den47k/incident-recorder/docs/screenshots/wokwi-uart.png

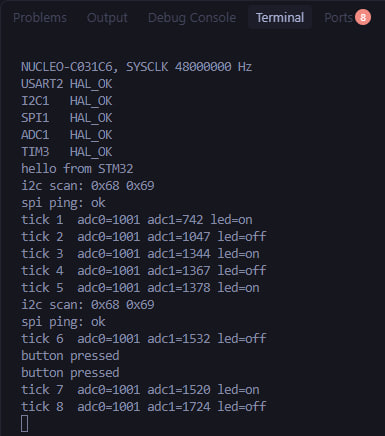
docs/screenshots/wokwi-uart.png
