den47k/incident-recorder/docs/hardware-components.md

# Апаратні компоненти Incident Recorder

## 1. Плата NUCLEO-C031C6
* **Мікроконтролер:** STM32C031C6 у корпусі LQFP48. Ядро Cortex-M0+ на 48 МГц, 32 КБ Flash, 12 КБ RAM.
* **Живлення:** плата живиться від USB через вбудований ST-LINK. Сам мікроконтролер працює від 2.0 до 3.6 В.
* **Тактування:** внутрішній генератор HSI на 48 МГц без дільника. На такій частоті Flash потребує 1 такт очікування, CubeMX виставляє його сам.
* **Піни інтерфейсів:**
  * USART2: PA2 - TX, PA3 - RX (AF1).
  * I2C1: PA9 - SCL, PA10 - SDA (AF6). На кристалі цей самий I2C1 виведений ще на PB6/PB7, але модель Wokwi працює тільки з PA9/PA10.
  * SPI1: PB3 - SCK, PB4 - MISO, PB5 - MOSI (AF0). CS - звичайний вихід PB0.
  * ADC1: PA0 - канал IN0, PA1 - канал IN1.
  * TIM3_CH1 (ШІМ): PA6 (AF1).
  * Кнопка: PA12 (лінія EXTI12). Вбудований світлодіод LD4: PA5.
* **Datasheet (DS13867 Rev 3, STM32C031x4/x6):** <https://www.farnell.com/datasheets/3916623.pdf>
  * с. 1 - параметри мікроконтролера і живлення
  * с. 31 - піни АЦП
  * с. 36–37 - альтернативні функції портів A і B
* **Reference manual (RM0490):** <https://www.st.com/resource/en/reference_manual/rm0490-stm32c0-series-advanced-armbased-32bit-mcus-stmicroelectronics.pdf>
  * с. 59 - такти очікування Flash
  * с. 125 - генератор HSI48

P.S. Було обрано NUCLEO-C031C6, а не F411/F446, тому що Wokwi не вміє симулювати F4. З STM32 у ньому є тільки C031C6, L031K6 і F103C8 (Bluepill), і з них лише C031C6 - повноцінна Nucleo-64 з підтримкою в CubeMX.

## 2. Акселерометр і гіроскоп MPU-6050
* **Живлення:** 2.375–3.46 В з піна 3V3. З увімкненими акселерометром і гіроскопом бере близько 3.9 мА, тож окреме джерело не потрібне.
* **Інтерфейс:** I2C, максимум 400 кГц. У проєкті шина працює на 100 кГц.
* **Підключення:** SCL - PA9, SDA - PA10, обидві лінії підтягнуті до 3V3 резисторами 4.7 кОм.
* **Адреса:** 0x68, коли пін AD0 на землі, і 0x69, коли на VCC. Модель у Wokwi відповідає на обидві, тому скан показує `0x68 0x69`.
* **Перевірка чіпа:** регістр WHO_AM_I (0x75) повертає 0x68.
* **Запуск:** після подачі живлення датчик у режимі сну. Щоб він почав міряти, у PWR_MGMT_1 (0x6B) треба записати 0.
* **Дані:** 14 байт підряд з адреси 0x3B: три осі прискорення, температура, три осі гіроскопа, кожне значення - два байти, старший першим.
* **Масштаб:** у діапазоні +-2g одне g дорівнює 16384 одиницям. Температура в °C = значення / 340 + 36.53.
* **Datasheet:** <https://cdn.sparkfun.com/datasheets/Components/General%20IC/PS-MPU-6000A.pdf>
  * с. 14 - живлення і струм
  * с. 15 - адреса на шині I2C
  * с. 36 - інтерфейс I2C
* **Карта регістрів:** <https://cdn.sparkfun.com/datasheets/Sensors/Accelerometers/RM-MPU-6000A.pdf>
  * с. 9 - режим сну після ввімкнення
  * с. 30–32 - регістри даних і масштаб
  * с. 41 - PWR_MGMT_1
  * с. 46 - WHO_AM_I

## 3. Фоторезистор GM5528
* **Живлення:** 3.3 В з піна 3V3.
* **Інтерфейс:** аналоговий вихід AO на PA0 (ADC1_IN0), 12 біт, тобто значення від 0 до 4095.
* **Схема:** фоторезистор і резистор 10 кОм утворюють дільник напруги, AO - точка між ними. Що темніше, то більший опір фоторезистора і то вища напруга на AO.
* **Характеристики:** у реального GM5528 при 10 лк опір 10–20 кОм, у темряві близько 1 МОм. Модель у Wokwi має 50 кОм при 10 лк і показник γ = 0.7.
* **Datasheet (серія GM55):** <https://www.sparkinter.com/pdf/120300-0056590.pdf>
  * с. 1 - характеристики GM5528

## 4. NTC-термістор 10 кОм
* **Живлення:** 3.3 В з піна 3V3.
* **Інтерфейс:** аналоговий вихід OUT на PA1 (ADC1_IN1), 12 біт, тобто значення від 0 до 4095.
* **Схема:** термістор і резистор 10 кОм утворюють дільник напруги, OUT - точка між ними. Що тепліше, то менший опір термістора і то нижча напруга на OUT.
* **Характеристики:** 10 кОм при 25 °C. У реального Vishay NTCLE100E3103 коефіцієнт B = 3977 K, модель у Wokwi має β = 3950. Температуру рахуємо з опору за формулою 1/T = 1/T0 + ln(R/R0)/β, де T0 = 298.15 K, R0 = 10 кОм.
* **Datasheet:** <https://www.vishay.com/docs/29049/ntcle100.pdf>
  * с. 2 - опір і коефіцієнт B для NTCLE100E3103

## 5. microSD-картка (замість флеш-пам'яті W25Q64)
* **Живлення:** 3.3 В з піна 3V3.
* **Інтерфейс:** SPI у режимі 0 (CPOL = 0, CPHA = 0). Поки картку не ініціалізовано, частота має бути не вище 400 кГц, тому SPI1 налаштований на 375 кГц (48 МГц / 128).
* **Піни:** SCK - PB3, DO - PB4 (MISO), DI - PB5 (MOSI), CS - PB0.
* **Команди:** ініціалізація йде послідовністю CMD0, CMD8, ACMD41, CMD58. Дані читаються й пишуться блоками по 512 байт: CMD17 - читання, CMD24 - запис.
* **Специфікація SD (Physical Layer Simplified Specification, версія 6.00):** <https://academy.cba.mit.edu/classes/networking_communications/SD/SD.pdf>
  * с. 94 - частота під час ініціалізації
  * с. 229 - порядок ініціалізації в режимі SPI
  * с. 230 - розмір блоку
  * с. 238 - команди CMD17 і CMD24
* **Datasheet W25Q64:** <https://www.winbond.com/resource-files/w25q64jv%20revj%2003272018%20plus.pdf>

## 6. Дисплей LCD1602 з I2C-перехідником PCF8574
* **Живлення:** реальний модуль розрахований на 5 В, у симуляторі вистачає 3.3 В.
* **Інтерфейс:** I2C, адреса 0x27 (у PCF8574T адресні піни A0–A2 підтягнуті до 1). Дисплей сидить на одній шині з MPU-6050.
* **Принцип роботи:** PCF8574 перетворює I2C на 8 окремих ліній. P0 - RS, P1 - R/W, P2 - E, P3 - підсвітка, P4–P7 - дані D4–D7. Сам дисплей керується контролером HD44780 у 4-бітному режимі.
* **Datasheet PCF8574:** <https://www.ti.com/lit/ds/symlink/pcf8574.pdf>
  * с. 14 - таблиця адрес
* **Datasheet HD44780:** <https://www.sparkfun.com/datasheets/LCD/HD44780.pdf>
  * с. 46 - ініціалізація в 4-бітному режимі

## 7. Кнопка
* **Інтерфейс:** GPIO-вхід з перериванням EXTI по спаду.
* **Підключення:** PA12 - кнопка - GND. Зовнішній резистор не потрібен, у мікроконтролері ввімкнена підтяжка вгору.

## 8. Світлодіоди
* **Інтерфейс:** GPIO-вихід, світлодіод горить при високому рівні на піні.
* **LD4:** вбудований на платі, пін PA5.
* **EVENT:** PA7, зовнішній, через резистор 330 Ом на GND (струм близько 4 мА).

## 9. Логічний аналізатор (вбудований у Wokwi)
* **Канали:** 8 штук. D0 - SCL, D1 - SDA, D2 - SCK, D3 - MOSI, D4 - MISO, D5 - CS, D6 - TX UART, D7 - PA5 (LD4).
* **Результат:** після зупинки симуляції запис зберігається у `docs/wokwi.vcd`, його можна відкрити в PulseView або GTKWave.
* **Навіщо:** на кроці 6 методички по ньому видно, що шини реально працюють: такти на SCL і SCK, адресу і ACK від MPU-6050.
* **Документація:** <https://docs.wokwi.com/parts/wokwi-logic-analyzer>
