den47k/incident-recorder/docs/PRD.md

# PRD: Incident Recorder

Реєстратор подій для вантажу і складських приміщень.

## A. Загальна ідея

Пристрій кладуть у ящик з вантажем або ставлять на складі, і він записує все, що з ним відбувається: удари, вихід температури за допустимі межі, увімкнене світло в закритому приміщенні. Кожна подія зберігається в пам'яті разом з часом і показами датчиків. Пам'ять не стирається при перезавантаженні, тож після доставки можна подивитись повну історію через UART.

Прошивка одна, але має два режими:
* **cargo** - пристрій їде разом з вантажем (медичне обладнання, оптика, електроніка) і стежить за ударами та температурою.
* **site** - пристрій стоїть на стелажі або на дверях сховища і стежить за вібрацією та світлом.

Після постановки на охорону пристрій можна «опломбувати» паролем. Тоді зняти його з охорони без пароля не вийде, і отримувач може бути певен, що запис ніхто не переривав.

## B. Функціональні вимоги

* **FR-01:** Система повинна мати два режими, `site` і `cargo`, і перемикати їх командою `mode` по UART без перепрошивки.
* **FR-02:** Система повинна опитувати акселерометр, фоторезистор і термістор щонайменше 50 разів на секунду (цикл 20 мс).
* **FR-03:** Система повинна записувати подію `SHOCK`, коли прискорення відхиляється від 1g більше ніж на заданий поріг (за замовчуванням 350 mg), не пізніше ніж через 40 мс.
* **FR-04:** У режимі `site` система повинна записувати подію `LIGHT`, коли значення з фоторезистора відрізняється від рівня на момент постановки на охорону більше ніж на поріг (за замовчуванням 400 одиниць АЦП).
* **FR-05:** У режимі `cargo` система повинна записувати подію `TEMP`, коли температура виходить за межі діапазону (за замовчуванням від 2 до 35 °C).
* **FR-06:** Система повинна записувати не більше однієї події на 3 секунди, щоб один довгий удар чи струс не заповнив увесь журнал.
* **FR-07:** Журнал повинен зберігатися в зовнішній пам'яті по SPI (microSD у симуляторі, W25Q64 на залізі) і читатися після перезавантаження.
* **FR-08:** Журнал повинен вміщати 128 записів і після заповнення перезаписувати найстаріші. Кожен запис має контрольну суму CRC-16, пошкоджені записи не показуються.
* **FR-09:** Система повинна приймати команди по UART (115200, 8N1): `help`, `status`, `mode`, `arm`, `disarm`, `thr`, `log`, `clear`, `seal`, `unseal`, `selftest`.
* **FR-10:** Кнопка повинна ставити пристрій на охорону і знімати з неї без хибних спрацювань від брязкоту контактів. Коли пристрій опломбований, кнопка не знімає охорону.
* **FR-11:** Світлодіод ARMED повинен горіти, поки пристрій на охороні. Після кожної події на 1 секунду вмикаються світлодіод EVENT і звуковий сигнал 4 кГц.
* **FR-12:** Дисплей повинен показувати режим, стан охорони, освітленість, температуру і кількість записів у журналі, оновлюючись не рідше двох разів на секунду.
* **FR-13:** Команда `selftest` повинна просканувати шину I2C і вивести знайдені адреси (очікуються 0x27 і 0x68), а також показати обидва канали АЦП і стан SPI-пам'яті.
* **FR-14:** Після ввімкнення система повинна вивести результат ініціалізації кожної периферії (USART2, I2C1, SPI1, ADC1, TIM3) і записати в журнал подію `BOOT`.

## C. Список датчиків

### 1. MPU-6050 (акселерометр і гіроскоп)
* **Інтерфейс:** I2C, адреса 0x68.
* **Призначення:** ловить удари і вібрацію в обох режимах (FR-03). Удар визначаємо за тим, наскільки сумарне прискорення відхилилось від 1g.
* **Альтернативи:**
  * ADXL345 - має лише акселерометр. Гіроскоп знадобиться пізніше, щоб помічати перекидання ящика.
  * GY-89 - ще й з магнітометром, але в Wokwi такого модуля немає.
  * Вібродатчик SW-420 - видає тільки «є вібрація / нема», без сили удару, тому поріг у mg на ньому не задати.

### 2. Фоторезистор GM5528
* **Інтерфейс:** АЦП, канал IN0 (PA0).
* **Призначення:** у режимі site різка зміна світла означає, що в закрите приміщення хтось зайшов або відкрив двері (FR-04).
* **Альтернативи:**
  * PIR-датчик руху - реагує лише на людей у полі зору і не помітить, наприклад, ліхтарик чи відкриту кришку ящика.
  * BH1750 - точніший і одразу видає люкси по I2C, але тоді в проєкті не лишилось би жодного аналогового датчика, а АЦП ми хотіли освоїти.

### 3. NTC-термістор 10 кОм
* **Інтерфейс:** АЦП, канал IN1 (PA1).
* **Призначення:** контроль температури вантажу в режимі cargo (FR-05), наприклад для ліків, яким не можна перегріватися.
* **Альтернативи:**
  * DHT22 - ще й міряє вологість, але працює по однопровідному протоколу з жорсткими таймінгами, для якого потрібен окремий драйвер.
  * Вбудований датчик температури в MPU-6050 - показує температуру самого чипа, а не вантажу.

### 4. microSD-картка (журнал подій)
* **Інтерфейс:** SPI1, режим 0.
* **Призначення:** зберігає журнал, який переживає перезавантаження (FR-07, FR-08). Дані будуть записуватися блоками по 512 байт напряму, без файлової системи.
* **Альтернативи:**
  * W25Q64 - саме її планується ставити на залізі, але в Wokwi її моделі немає.
  * Внутрішня Flash мікроконтролера - всього 32 КБ, і майже все займає прошивка.
  * Файлова система FatFs на microSD - зручно читати з комп'ютера, але бібліотека не влазить у 32 КБ разом з HAL.

### 5. Кнопка, світлодіоди, п'єзовипромінювач
* **Інтерфейс:** кнопка на PA12 з перериванням EXTI (FR-10), світлодіоди на PA5 і PA7.

### 6. Дисплей LCD1602 з PCF8574
* **Інтерфейс:** I2C, адреса 0x27, на одній шині з MPU-6050 (FR-12).

## D. План тестування

Усі тести проводяться в симуляторі Wokwi:
* **Вручну** - у VS Code: повзунки на датчиках, кнопка, Serial Monitor.
* **Автоматично** - через `wokwi-cli` і сценарій YAML. Крок `set-control` змінює показ датчика або натискає кнопку (у MPU-6050 це `accelX/Y/Z`, у фоторезистора `lux`, у кнопки `pressed`), `write-serial` надсилає команду, `wait-serial` чекає потрібний рядок у UART.
* **Логічним аналізатором** - після зупинки симуляції запис лежить у `docs/wokwi.vcd`.

### Тести для фунціональних вимог
* **FR-01:** надіслати `mode cargo`, потім `status`. Очікуємо `mode=cargo`. Якщо пристрій на охороні, зміна режиму має відхилятися.
* **FR-02:** логічним аналізатором на SCL/SDA виміряти інтервал між зверненнями до 0x68. Має бути не більше 20 мс.
* **FR-03:** поставити на охорону, сценарієм змінити `accelZ` MPU-6050 з 1 на 2. У UART має з'явитися `SHOCK`. Для виміру затримки на канал аналізатора додаємо PA7 (EVENT): від I2C-читання з новим значенням до вмикання EVENT - не більше 40 мс.
* **FR-04:** режим site, постановка на охорону, сценарієм змінити `lux` з 500 на 10 000. Має записатися `LIGHT`.
* **FR-05:** режим cargo, постановка на охорону, у VS Code підняти температуру NTC до 40 °C (у сценаріях Wokwi NTC не керується, тому вручну). Має записатися `TEMP`. Якщо перед цим підняти верхню межу до 50 °C, події бути не повинно.
* **FR-06:** тримати `accelZ = 2` 10 секунд. У журналі має бути 4 записи (0, 3, 6 і 9 с), а не сотні.
* **FR-07:** викликати 5 подій, скинути мікроконтролер кнопкою на піні NRST, не зупиняючи симуляцію, і виконати `log`. Мають бути всі 5 записів. Перезапускати саму симуляцію не можна: Wokwi при кожному старті створює microSD заново, і тест провалиться незалежно від прошивки.
* **FR-08:** вимкнути обмеження частоти (`thr rate 0`) і викликати понад 128 подій. `log` має показати рівно 128 останніх, без пошкоджених.
* **FR-09:** сценарієм надіслати `help` і кожну команду з неправильними аргументами. Кожна має відповісти, на невідому команду має прийти повідомлення про помилку.
* **FR-10:** сценарієм натиснути кнопку 5 разів. Стан охорони має змінитися рівно 5 разів. Після `seal` натискання не повинно знімати охорону.
* **FR-11:** викликати подію. На аналізаторі EVENT (PA7) має горіти 1 секунду, на PA6 має бути сигнал 4 кГц.
* **FR-12:** подивитися на дисплей у симуляторі: у першому рядку режим і стан, у другому освітленість, температура і кількість записів. Оновлення не рідше двох разів на секунду.
* **FR-13:** виконати `selftest`. У виводі мають бути адреси 0x27 і 0x68 (у Wokwi ще й 0x69), два значення АЦП у межах 0–4095 і стан SPI-пам'яті.
* **FR-14:** перезапустити симуляцію. Крім п'яти рядків `HAL_OK`, у журналі має з'явитися подія `BOOT`.
