den47k/incident-recorder/docs/screenshots/wokwi-sim.png

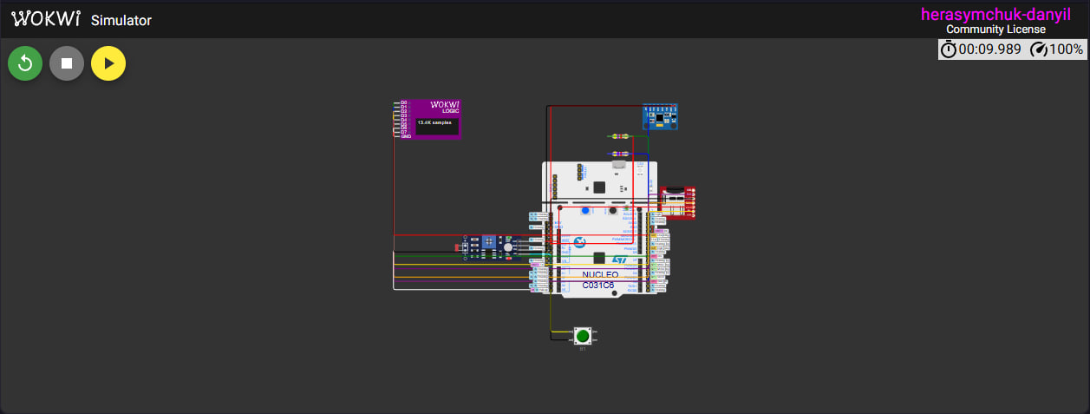
docs/screenshots/wokwi-sim.png
