den47k/incident-recorder/firmware/firmware.ioc

Mcu.UserName=STM32C031C6Tx
PA0.Signal=ADC1_IN0
PA1.Signal=ADC1_IN1
PA10.Signal=I2C1_SDA
PA13.GPIO_Label=DEBUG_SWDIO
PA13.Signal=DEBUG_SWDIO
PA14-BOOT0.GPIO_Label=DEBUG_SWCLK
PA14-BOOT0.Signal=DEBUG_SWCLK
PA2.GPIO_Label=VCP_USART2_TX
PA2.Signal=USART2_TX
PA3.GPIO_Label=VCP_USART2_RX
PA3.Signal=USART2_RX
PA5.Signal=GPIO_Output
PA6.Signal=S_TIM3_CH1
PA9.Signal=I2C1_SCL
PB0.Signal=GPIO_Output
PB3.Signal=SPI1_SCK
PB4.Signal=SPI1_MISO
PB5.Signal=SPI1_MOSI
