den47k/incident-recorder/firmware/Core/Inc/main.h

#define VCP_USART2_TX_Pin GPIO_PIN_2
#define VCP_USART2_TX_GPIO_Port GPIOA
#define VCP_USART2_RX_Pin GPIO_PIN_3
#define VCP_USART2_RX_GPIO_Port GPIOA
#define DEBUG_SWDIO_Pin GPIO_PIN_13
#define DEBUG_SWDIO_GPIO_Port GPIOA
#define DEBUG_SWCLK_Pin GPIO_PIN_14
#define DEBUG_SWCLK_GPIO_Port GPIOA
