den47k/incident-recorder/(commit log)

2026-09-19 Set up Docker toolchain for STM32 builds
2026-09-23 Generate STM32C031 project in CubeMX
2026-09-23 Add UART log, I2C/SPI checks, ADC readings and button handling
